willsowerbutts/ersatz80/hardware-schematic-rev2.pdf

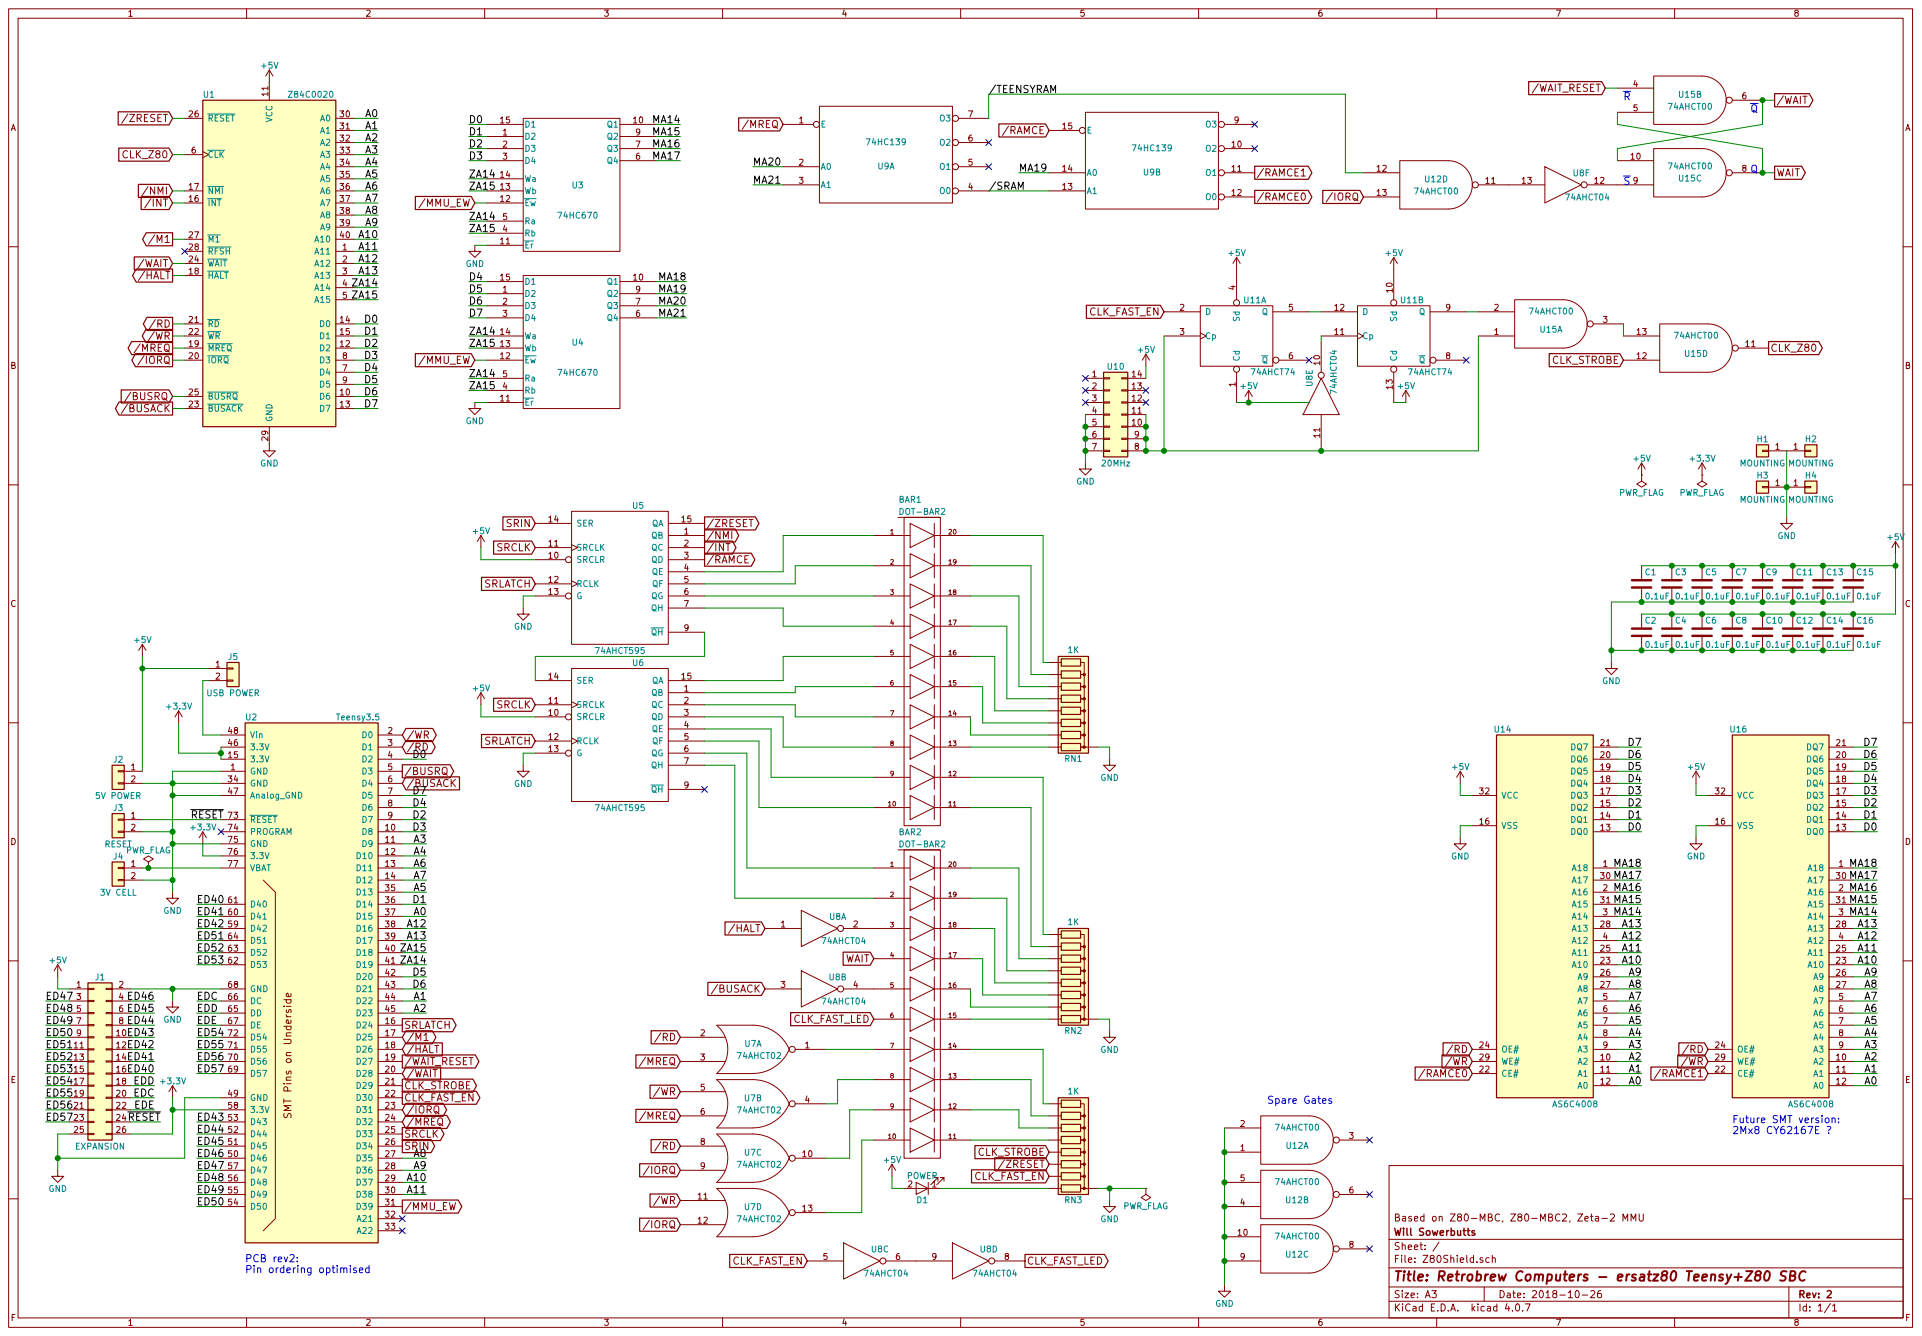
[picture p2: page 1]

5 | 10

15 | 16
17 | 18 | EDD
19 | 20 | EDC
21 | 22 | EDE

File: Z80Shield.sch Sheet: / Will Sowerbutts Based on Z80-MBC, Z80-MBC2, Zeta-2 MMU

Id: 1/1 Title: Retrobrew Computers - ersatz80 Teensy+Z80 SBC
