willsowerbutts/ersatz80/super.cpp

#include <string.h>
#include <stdlib.h>
#include <stdio.h>
#include "z80.h"
#include "z80io.h"
#include "clock.h"
#include "serial.h"
#include "super.h"
#include "debug.h"
#include "rom.h"
#include "disk.h"

#define SBUFLEN 80
#define SMAXARG 10
int supervisor_cmd_offset = 0;
char supervisor_cmd_buffer[SBUFLEN];

typedef struct {
    const char *name;
    void (*function)(int argc, char *argv[]);
} cmd_entry_t;

void super_reset(int argc, char *argv[]);
void super_regs(int argc, char *argv[]);
void super_clk(int argc, char *argv[]);
void super_step(int argc, char *argv[]);
void super_loadrom(int argc, char *argv[]);
void super_loadfile(int argc, char *argv[]);
void super_trace(int argc, char *argv[]);
void super_ls(int argc, char *argv[]);
void super_rm(int argc, char *argv[]);
void super_cp(int argc, char *argv[]);
void super_mv(int argc, char *argv[]);
void super_disk(int argc, char *argv[]);
void super_sync(int argc, char *argv[]);
void super_format(int argc, char *argv[]);
void super_help(int argc, char *argv[]);
void super_in(int argc, char *argv[]);
void super_out(int argc, char *argv[]);
void super_run(int argc, char *argv[]);
void super_exec(int argc, char *argv[]);
void super_mode(int argc, char *argv[]);
void super_mount(int argc, char *argv[]);
void super_umount(int argc, char *argv[]);
void super_uart0(int argc, char *argv[]);

const cmd_entry_t cmd_table[] = {
    { "help",       &super_help     }, // despite the name, not actually super helpful
    { "quit",       NULL            },
    { "exit",       NULL            },
    { "q",          NULL            },
    { "uart0",      &super_uart0    },
    { "regs",       &super_regs     },
    { "clk",        &super_clk      },
    { "clock",      &super_clk      },
    { "step",       &super_step     },
    { "s",          &super_step     },
    { "reset",      &super_reset    },
    { "loadrom",    &super_loadrom  },
    { "loadfile",   &super_loadfile },
    { "trace",      &super_trace    },
    { "ls",         &super_ls       },
    { "dir",        &super_ls       },
    { "mv",         &super_mv       },
    { "ren",        &super_mv       },
    { "rename",     &super_mv       },
    { "rm",         &super_rm       },
    { "del",        &super_rm       },
    { "cp",         &super_cp       },
    { "copy",       &super_cp       },
    { "disk",       &super_disk     },
    { "disks",      &super_disk     },
    { "mount",      &super_mount    },
    { "unmount",    &super_umount   },
    { "umount",     &super_umount   },
    { "format",     &super_format   },
    { "sync",       &super_sync     },
    { "in",         &super_in       },
    { "out",        &super_out      },
    { "run",        &super_run      },
    { "exec",       &super_exec     },
    { "mode",       &super_mode     },

    // list terminator:
    { NULL,         NULL            }
};

static bool not_in_supervised_mode(void)
{
    if(clk_is_supervised())
        return false;
    report("ersatz80: this command can only be used in supervisor mode\r\n");
    return true;
}

bool parse_int16(const char *arg, uint16_t *value, int base)
{
    char *endptr = NULL;
    uint16_t val;

    *value = 0;
    val = strtol(arg, &endptr, base);
    if(val == 0 && endptr == NULL)
        return false;
    if(*endptr != 0 && !isspace(*endptr))
        return false;

    *value = val;
    return true;
}

bool supervisor_menu_key_in(unsigned char keypress)
{
    if(keypress == 0x7f || keypress == 0x08){ // backspace and delete
        if(supervisor_cmd_offset > 0){
            Serial.write("\x08 \x08"); // erase last char
            supervisor_cmd_offset--;
        }
    }else if(keypress == 0x0d || keypress == 0x0a){
        supervisor_cmd_buffer[supervisor_cmd_offset] = 0;
        report("\r\n");
        execute_supervisor_command(supervisor_cmd_buffer);
        return false;
    }else if(keypress == 0x1B /* Esc */ || keypress == SUPERVISOR_ESCAPE_KEYCODE){
        report("*abort*\r\n");
        return false;
    }else if(keypress >= 0x20){
        if(supervisor_cmd_offset < (SBUFLEN-1)){
            supervisor_cmd_buffer[supervisor_cmd_offset++] = keypress;
            report("%c", keypress);
        }else{
            Serial.write(0x07); // sound the bell
        }
    }
    return true;
}

void supervisor_menu_enter(void)
{
    supervisor_cmd_offset = 0;
    report("Supervisor> ");
}

bool execute_supervisor_command(char *cmd_buffer) // return false on exit/quit etc, true otherwise
{
    int argc = 0;
    char *p, *argv[SMAXARG];

    p = cmd_buffer;
    while(*p){
        while(isspace(*p)) // skip over leading whitespace
            p++;
        if(!*p) // end of line?
            break;
        argv[argc++] = p; // store ptr to start of command
        while(*p && !isspace(*p)) // find end of command
            p++;
        if(!*p) // end of line?
            break;
        *(p++) = 0; // overwrite whitespace with NUL
    }

    if(argc == 0)
        return true;

    for(const cmd_entry_t *cmd=cmd_table; cmd->name; cmd++){
        if(!strcasecmp(argv[0], cmd->name)){
            if(cmd->function == NULL){
                return false;
            }else{
                cmd->function(argc-1, argv+1);
                return true;
            }
        }
    }

    report("error: unknown command \"%s\"\r\n", argv[0]);

    return true;
}

void super_regs(int argc, char *argv[])
{
    // parsing isn't quite right
    // it'd be nice to be able to run: regs hl=1111 bc=2222 de=3333 af=0000 (etc)
    if(argc == 1 && !strcasecmp(argv[0], "show"))
        z80_show_regs();
    else if(argc == 2){
        uint16_t value;
        if(!parse_int16(argv[1], &value, 16)){
            report("error: bad register value\r\n");
            return;
        }
        if(     !strcasecmp(argv[0], "AF"))  z80_set_register(Z80_REG_AF,     value);
        else if(!strcasecmp(argv[0], "BC"))  z80_set_register(Z80_REG_BC,     value);
        else if(!strcasecmp(argv[0], "DE"))  z80_set_register(Z80_REG_DE,     value);
        else if(!strcasecmp(argv[0], "HL"))  z80_set_register(Z80_REG_HL,     value);
        else if(!strcasecmp(argv[0], "IX"))  z80_set_register(Z80_REG_IX,     value);
        else if(!strcasecmp(argv[0], "IY"))  z80_set_register(Z80_REG_IY,     value);
        else if(!strcasecmp(argv[0], "AF'")) z80_set_register(Z80_REG_AF_ALT, value);
        else if(!strcasecmp(argv[0], "BC'")) z80_set_register(Z80_REG_BC_ALT, value);
        else if(!strcasecmp(argv[0], "DE'")) z80_set_register(Z80_REG_DE_ALT, value);
        else if(!strcasecmp(argv[0], "HL'")) z80_set_register(Z80_REG_HL_ALT, value);
        else if(!strcasecmp(argv[0], "PC"))  z80_set_register(Z80_REG_PC,     value);
        else if(!strcasecmp(argv[0], "SP"))  z80_set_register(Z80_REG_SP,     value);
        else if(!strcasecmp(argv[0], "I"))   z80_set_register(Z80_REG_I,      value);
        else report("Unrecognised register\r\n");
    }else{
        report("syntax: regs [show|af|bc|de|hl|ix|iy|af'|bc'|de'|hl'|pc|sp|i] <value>\r\n");
    }
}

void super_step(int argc, char *argv[])
{
    if(not_in_supervised_mode())
        return;

    while(instruction_clock_cycles == 0){
        z80_clock_pulse();
        handle_z80_bus();
    }

    while(instruction_clock_cycles != 0){
        z80_clock_pulse();
        handle_z80_bus();
    }
}

void super_clk(int argc, char *argv[])
{
    float f;
    bool setclk = true;

    if(argc == 0){
        setclk = false; // we just want the report that follows
    }else if(argc == 1 && !strcasecmp(argv[0], "fast")){
        f = CLK_FAST_FREQUENCY;
    }else if(argc == 1){
        char *endptr = NULL;
        f = strtof(argv[0], &endptr);
        if(f == 0 && endptr == argv[0]){
            report("error: bad frequency\r\n");
            return;
        }else{
            switch(*endptr){
                case 0:
                    break;
                case 'k':
                case 'K':
                    f *= 1000;
                    break;
                case 'm':
                case 'M':
                    f *= 1000000;
                    break;
                case 'g': // possibly getting a bit ambitious here!
                case 'G':
                    f *= 1000000000;
                    break;
                default:
                    report("error: unrecognised unit suffix?\r\n");
                    return;
            }
        }
    }else{
        report("error: syntax: clk [fast|<freq[kHz|MHz|GHz]>]\r\n");
        return;
    }

    if(setclk){
        if(clk_is_supervised())
            clk_set_supervised_frequency(f);
        else
            clk_set_unsupervised_frequency(f);
    }

    report("clock: %s ", clk_is_supervised() ? "supervised" : "unsupervised");
    f = clk_is_supervised() ? clk_get_supervised_frequency() : clk_get_unsupervised_frequency();
    if(f >= 950000.0)
        report("%.3fMHz", f / 1000000.0);
    else if(f > 950.0)
        report("%.3fkHz", f / 1000.0);
    else
        report("%.3fHz", f);
    report("\r\n");
}

void super_loadrom(int argc, char *argv[])
{
    load_program_to_sram(monitor_rom, MONITOR_ROM_START, MONITOR_ROM_SIZE, MONITOR_ROM_START);
    report("loadrom: monitor loaded at %04x\r\n", MONITOR_ROM_START);
}

void super_reset(int argc, char *argv[])
{
    z80_do_reset();
}

// loadfile could be improved: take a file start offset and a byte count to load?
void super_loadfile(int argc, char *argv[])
{
    int r;
    if(argc < 2){
        report("error: syntax: loadfile [filename] [address]\r\n"
                "note: address is in hex\r\n");
    }else {
        uint16_t address;
        if(!parse_int16(argv[1], &address, 16)){
            report("error: bad load address\r\n");
        }else{
            report("loadfile \"%s\" at 0x%04x: ", argv[0], address);
            r = load_file_to_sram(argv[0], address);
            if(r < 0)
                report("failed\r\n");
            else
                report("loaded %d bytes\r\n", r);
        }
    }
}

void super_trace(int argc, char *argv[])
{
    bool help = false;

    if(not_in_supervised_mode())
        return;

    if(argc != 1)
        help = true;
    else{
        if(!strcasecmp(argv[0], "silent") || !strcasecmp(argv[0], "off"))
            z80_bus_trace = TR_SILENT;
        else if(!strcasecmp(argv[0], "inst"))
            z80_bus_trace = TR_INST;
        else if(!strcasecmp(argv[0], "bus"))
            z80_bus_trace = TR_BUS;
        else
            help = true;
    }

    if(help){
        report("error: trace [off|silent|inst|bus]\r\n");
    }
}

void super_disk(int argc, char *argv[])
{
    for(int d=0; d<NUM_DISK_DRIVES; d++){
        report("Disk %d: filename \"%s\", ", d, disk[d].filename);
        if(disk[d].mounted){
            report("mounted, %.3fMB, %d x %d byte sectors, %s\r\n",
                    (float)disk[d].size_bytes / (1024.0 * 1024.0),
                    disk[d].size_bytes >> disk[d].sector_size_log,
                    1 << disk[d].sector_size_log,
                    disk[d].writable ? "read-write" : "read-only");
        }else{
            report("unmounted\r\n");
        }
    }
}

void super_ls(int argc, char *argv[])
{
    sdcard.ls(LS_DATE | LS_SIZE | LS_R);
    // TODO: improve this!
}

void super_sync(int argc, char *argv[])
{
    disk_sync();
}

void super_format(int argc, char *argv[])
{
    if(argc != 2){
        report("error: syntax: format [filename] [size]\r\n"
               "note: size is in bytes; add K suffix for KB, M suffix for MB, G suffix for GB.\r\n");
    }else{
        float size = 0;
        char *endptr = NULL;
        uint32_t sb;
        size = strtof(argv[1], &endptr);
        if(size == 0 && endptr == argv[0]){
            report("error: bad size\r\n");
            return;
        }else{
            switch(*endptr){
                case 0:
                    break;
                case 'g':
                case 'G':
                    size *= 1024;
                    // fall through
                case 'm':
                case 'M':
                    size *= 1024;
                    // fall through
                case 'k':
                case 'K':
                    size *= 1024;
                    break;
                default:
                    report("error: unrecognised unit suffix?\r\n");
                    return;
            }
        }
        if(size > (2.0f * 1024.0 * 1024.0 * 1024.0)){
            report("error: maximum supported disk size is 2GB\r\n");
            return;
        }
        sb = (uint32_t)size;
        if(sb & 0x3FF)
            report("disk: WARNING: size is not a multiple of 1024 (good luck)\r\n");
        if(disk_format(argv[0], sb))
            report("disk: successfully formatted \"%s\" (%d bytes)\r\n", argv[0], sb);
        else
            report("disk: failed to format \"%s\" (%d bytes)\r\n", argv[0], sb);
    }
}

void super_rm(int argc, char *argv[])
{
    if(argc != 1){
        report("error: syntax: rm [filename]\r\n");
    }else{
        if(!disk_rm(argv[0]))
            report("error: rm failed\r\n");
    }
}

void super_cp(int argc, char *argv[])
{
    if(argc != 2){
        report("error: syntax: cp [source] [target]\r\n");
    }else{
        if(!disk_cp(argv[0], argv[1]))
            report("error: cp failed\r\n");
    }
}

void super_mv(int argc, char *argv[])
{
    if(argc != 2){
        report("error: syntax: mv [source] [target]\r\n");
    }else{
        if(!disk_mv(argv[0], argv[1]))
            report("error: cp failed\r\n");
    }
}

void super_uart0(int argc, char *argv[])
{
    int baud;
    char *endptr = NULL;

    if(argc == 1){
        if(strcasecmp(argv[0], "usb") == 0){
            uart0_on_console = true;
            report("uart0: using usb ACM device\r\n");
            return;
        }

        if(strcasecmp(argv[0], "uart") == 0){
            baud = 115200;
        }else{
            baud = strtol(argv[0], &endptr, 10);
            if(baud == 0 || !endptr || *endptr != 0)
                baud = 0;
        }

        if(baud){
            uart_setup(baud);
            report("uart0: using UART6 at %d baud\r\n", baud);
            if(uart0_on_console)
                supervisor_menu_enter();
            uart0_on_console = false;
            return;
        }

        report("error: syntax: uart0 [usb|uart|<baud>]\r\n");
    }

}

void super_help(int argc, char *argv[])
{
    void (*prev_func)(int argc, char *argv[]) = NULL;

    report("commands:");
    for(const cmd_entry_t *cmd=cmd_table; cmd->name; cmd++){
        if(cmd->function != prev_func)
            report(" %s", cmd->name);
        prev_func = cmd->function;
    }
    report("\r\n");
}

void super_in(int argc, char *argv[])
{
    if(argc != 1){
        report("error: syntax: in [port]\r\n");
    }else {
        uint16_t port, value;
        if(!parse_int16(argv[0], &port, 16)){
            report("error: bad port address\r\n");
        }else{
            // TODO check this is safe (previously we would explicitly switch to DMA mode)
            value = iodevice_read(port);
            report("input from I/O port 0x%04x: 0x%02x\r\n", port, value);
        }
    }
}

void super_out(int argc, char *argv[])
{
    if(argc != 2){
        report("error: syntax: out [port] [value]\r\n");
    }else {
        uint16_t port, value;
        if(!parse_int16(argv[0], &port, 16)){
            report("error: bad port address\r\n");
        }else{
            if(!parse_int16(argv[1], &value, 16) || value > 0xFF)
                report("error: bad value\r\n");
            else{
                // TODO check this is safe (previously we would explicitly switch to DMA mode)
                iodevice_write(port, value);
            }
        }
    }
}

void super_run(int argc, char *argv[])
{
    if(argc != 1){
        report("error: syntax: run [address]\r\n");
    }else {
        uint16_t address;
        if(!parse_int16(argv[0], &address, 16)){
            report("error: bad address\r\n");
        }else{
            z80_mode_t prev_mode = z80_set_mode(Z80_SUPERVISED);
            z80_set_register(Z80_REG_PC, address);
            z80_set_mode(prev_mode);
        }
    }
}

void super_exec(int argc, char *argv[])
{
    if(argc != 1){
        report("error: syntax: exec [filename]\r\n");
        return;
    }

    SdBaseFile file;

    if(!file.open(&sdcard, argv[0], O_RDONLY)){
        report("exec: Cannot open \"%s\"\r\n", argv[0]);
        return;
    }
    // note that we shortly will overwrite the strings that argv[] point to, so can't use argv[0] again
    
    while(file.fgets(supervisor_cmd_buffer, SBUFLEN) > 0){
        int l = strlen(supervisor_cmd_buffer);
        while(l > 0 && isspace(supervisor_cmd_buffer[l-1])){
            supervisor_cmd_buffer[--l] = 0;
        }
        report("exec: \"%s\"\r\n", supervisor_cmd_buffer);
        execute_supervisor_command(supervisor_cmd_buffer);
    }

    file.close();
}

void super_mount(int argc, char *argv[])
{
    uint16_t disknum;
    bool readwrite = true;
    if(argc < 1 || argc > 3){
        report("error: syntax: mount [disknum] <filename> <ro|rw>\r\n");
        return;
    }
    if(!parse_int16(argv[0], &disknum, 10) || disknum >= NUM_DISK_DRIVES){
        report("error: bad disk number (0--%d)\r\n", NUM_DISK_DRIVES-1);
        return;
    }
    disk_unmount(disknum);
    if(argc >= 3){
        if(strcasecmp(argv[2], "ro") == 0)
            readwrite = false;
        else if(strcasecmp(argv[2], "rw") == 0)
            readwrite = true;
        else{
            report("error: bad read-only/read-write flag\r\n");
            return;
        }
    }
    if(argc >= 2){
        strncpy(disk[disknum].filename, argv[1], MAX_FILENAME_LENGTH);
        disk[disknum].filename[MAX_FILENAME_LENGTH-1] = 0; // ensure string is terminated
    }
    disk_mount(disknum, readwrite);
}

void super_umount(int argc, char *argv[])
{
    uint16_t disknum;
    if(argc != 1){
        report("error: syntax: unmount [disknum]\r\n");
        return;
    }
    if(!parse_int16(argv[0], &disknum, 10) || disknum >= NUM_DISK_DRIVES){
        report("error: bad disk number (0--%d)\r\n", NUM_DISK_DRIVES-1);
        return;
    }
    disk_unmount(disknum);
}

void super_mode(int argc, char *argv[])
{
    bool bad = false;
    
    if(argc > 1)
        bad = true;

    if(argc == 1){
        if(strcasecmp(argv[0], "supervised") == 0 || strcasecmp(argv[0], "s") == 0)
            z80_set_mode(Z80_SUPERVISED);
        else if(strcasecmp(argv[0], "unsupervised") == 0 || strcasecmp(argv[0], "u") == 0)
            z80_set_mode(Z80_UNSUPERVISED);
        else
            bad=true;
    }

    if(bad){
        report("error: syntax: mode [supervised|unsupervised|s|u]\r\n");
        return;
    }

    report("mode: %ssupervised\r\n", clk_is_supervised() ? "":"un");
}
