willsowerbutts/ersatz80/disasm.cpp

/* this is a modified version of disasm.c taken from:
 * z80ctrl (https://github.com/jblang/z80ctrl)
 * Copyright 2018 J.B. Langston
 *
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
 * THE SOFTWARE IS PROVIDED "AS IS", WITHOUT WARRANTY OF ANY KIND, EXPRESS OR
 * IMPLIED, INCLUDING BUT NOT LIMITED TO THE WARRANTIES OF MERCHANTABILITY,
 * FITNESS FOR A PARTICULAR PURPOSE AND NONINFRINGEMENT. IN NO EVENT SHALL THE
 * AUTHORS OR COPYRIGHT HOLDERS BE LIABLE FOR ANY CLAIM, DAMAGES OR OTHER
 * LIABILITY, WHETHER IN AN ACTION OF CONTRACT, TORT OR OTHERWISE, ARISING
 * FROM, OUT OF OR IN CONNECTION WITH THE SOFTWARE OR THE USE OR OTHER
 * DEALINGS IN THE SOFTWARE.
 */

#include <stdint.h>
#include <string.h>
#include <stdio.h>

/**
 * @file disasm.c Z80 disassembler
 *
 * This disassembler decodes Z80 instructions using techniques described
 * in http://www.z80.info/decoding.htm.
 */

/**
 *  8-bit registers
 */
const char *registers[] = {"B", "C", "D", "E", "H", "L", "(HL)", "A", "IXH", "IXL", "IYH", "IYL"};
enum {B, C, D, E, H, L, HLI, A, IXH, IXL, IYH, IYL};

/**
 *  16-bit register pairs
 */
const char *register_pairs[] = {"BC", "DE", "HL", "SP", "AF", "IX", "IY"};
enum {BC, DE, HL, _SP, AF, IX, IY};

/**
 * condition codes
 */
const char *conditions[] = {"NZ", "Z", "NC", "C", "PO", "PE", "P", "M"};

/**
 * arithmetic/logic operations
 */
const char *alu_ops[] = {"ADD A,", "ADC A,", "SUB ", "SBC A,", "AND ", "XOR ", "OR ", "CP "};

/**
 * rotation/shift operations
 */
const char *rot_ops[] = {"RLC", "RRC", "RL", "RR", "SLA", "SRA", "SLL", "SRL"};

/**
 * interrupt modes
 */
const char *int_modes[] = {"0", "0", "1", "2"};

/**
 * block instructions
 */
const char *block_ops[] = {
    "LDI", "LDD", "LDIR", "LDDR",
    "CPI", "CPD", "CPIR", "CPDR",
    "INI", "IND", "INIR", "INDR",
    "OUTI", "OUTD", "OTIR", "OTDR"
};

/**
 * indirect load ops
 */
const char *ld_ops[] = {"LD (BC),A", "LD A,(BC)", "LD (DE),A", "LD A,(DE)"};

/**
 * accumulator and flag ops for x = 0, z = 7
 */
const char *af_ops[] = {"RLCA", "RRCA", "RLA", "RRA", "DAA", "CPL", "SCF", "CCF"};

/**
 * miscellaneous 0xED operations
 */
const char *misc_ops[] = {"LD I,A", "LD R,A", "LD A,I", "LD A,R", "RRD", "RLD", "NOP", "NOP"};

const char *bit_ops[] = {"BIT", "RES", "SET"};

/**
 * disassemble a single instruction
 */
void z80ctrl_disasm(uint8_t (*input)(), char *output)
{
    uint8_t opcode = 0;
    uint8_t prefix = 0;
    uint8_t displ = 0;
    uint16_t operand = 0;
    uint8_t im = HL;

    // Consume any number of 0xDD and 0xFD prefix bytes
    // and set index mode according to last one encountered.
    for (;;) {
            opcode = input();
            if (opcode == 0xDD)
                im = IX;
            else if (opcode == 0xFD)
                im = IY;
            else
                break;
    }

    if (opcode == 0xED) {
            prefix = 0xED;
            im = HL;            // Index mode for 0xED prefix is always HL
            opcode = input();
    } if (opcode == 0xCB) {
        prefix = 0xCB;
        if (im != HL)
                displ = input();
        opcode = input();
    }

    // bit slice the opcode: xxyyyzzz / xxppqzzz
    uint8_t x = (opcode & 0300) >> 6;       // x = opcode[7:6]
    uint8_t y = (opcode & 0070) >> 3;       // y = opcode[5:3]
    uint8_t z = (opcode & 0007);            // z = opcode[2:0]
    uint8_t p = (opcode & 0060) >> 4;       // p = opcode[5:4]
    uint8_t q = (opcode & 0010) >> 3;       // q = opcode[3]
    uint8_t zy = ((z & 3) << 2) | (y & 3);  // zy = {opcode[1:0], opcode[4:3]}

    // choose registers based on index mode and y/z/p opcode fields
    const char *rp, *hli, *ry, *rz;
    rp = register_pairs[p == HL ? im : p];
    ry = registers[y];
    rz = registers[z];
    if (im == IX) {
        hli = register_pairs[IX];
    } else if (im == IY) {
        hli = register_pairs[IY];
    } else {
        hli = register_pairs[HL];
    }

    // Big ugly nested if tree to decode opcode
    if (prefix == 0xCB) {
        if (x == 0) {
            // Roll/shift register or memory location
            if (im == HL) {
                sprintf(output, "%s %s", rot_ops[y], rz);
            } else {
                sprintf(output, "%s (%s+0x%02x)", rot_ops[y], hli, displ);
            }
        } else {
            // Bit operations (test reset, set)
            if (im == HL) {
                sprintf(output, "%s %x,%s", bit_ops[x-1], y, rz);
            } else {
                sprintf(output, "%s %x,(%s+0x%02x)", bit_ops[x-1], y, hli, displ);
            }
        }
    } else if (prefix == 0xED) {
        if (x == 1) {
            if (z == 0) {
                // Input from port
                sprintf(output, (y == 6) ? "IN (C)" : "IN %s,(C)", ry);
            } else if (z == 1) {
                // Output to port
                sprintf(output, (y == 6) ? "OUT (C)" : "OUT (C),%s", ry);
            } else if (z == 2) {
                // 16-bit add/subtract with carry
                sprintf(output, (q == 0) ? "SBC HL,%s" : "ADC HL,%s", rp);
            } else if (z == 3) {
                // Retrieve/store register pair from/to immediate address
                operand = input() | (input() << 8);
                if (q == 0) {
                    sprintf(output, "LD (0x%04x),%s", operand, rp);
                } else {
                    sprintf(output, "LD %s,(0x%04x)", rp, operand);
                }
            } else if (z == 4) {
                // Negate accumulator
                strcpy(output, "NEG");
            } else if (z == 5) {
                // Return from interrupt
                strcpy(output, (y == 1) ? "RETI" : "RETN");
            } else if (z == 6) {
                // Set interrupt mode
                sprintf(output, "IM %s", int_modes[y&0x3]);
            } else if (z == 7) {
                // Assorted ops
                strcpy(output, misc_ops[y]);
            }
        } else if (x == 2 && z <= 3 && y >= 4) {
                strcpy(output, block_ops[zy]);
        } else {
            sprintf(output, "?");
        }
    } else {
        // un-prefixed opcodes
        if (x == 0) {
            if (z == 0) {
                // Relative jumps and assorted ops
                if (y == 0) {
                    strcpy(output, "NOP");
                } else if (y == 1) {
                    strcpy(output, "EX AF,AF'");
                } else {
                    operand = input();
                    if (y == 2) {
                        sprintf(output, "DJNZ %d", (int8_t)operand);
                    } else if (y == 3) {
                        sprintf(output, "JR %d", (int8_t)operand);
                    } else {
                        sprintf(output, "JR %s,%d", conditions[y-4], (int8_t)operand);
                    }
                }
            } else if (z == 1) {
                // 16-bit load immediate/add
                if (q == 0) {
                    operand = input() | (input() << 8);
                    sprintf(output, "LD %s,0x%04x", rp, operand);
                } else {
                    sprintf(output, "ADD %s,%s", hli, rp);
                }
            } else if (z == 2) {
                // Indirect loading
                if (y < 4) {
                    strcpy(output, ld_ops[y]);
                } else {
                    operand = input() | (input() << 8);
                    if (p == 3) {
                        hli = "A";
                    }
                    if (q == 0) {
                        sprintf(output, "LD (0x%04x),%s", operand, hli);
                    } else {
                        sprintf(output, "LD %s,(0x%04x)", hli, operand);
                    }
                }
            } else if (z == 3) {
                // 16-bit increment or decrement
                sprintf(output, (q == 0) ? "INC %s" : "DEC %s", rp);
            } else if (z == 4) {
                // 8-bit increment
                if (y == HLI && im != HL) {
                    displ = input();
                    sprintf(output, "INC (%s+0x%02x)", hli, displ);
                } else {
                    sprintf(output, "INC %s", ry);
                }
            } else if (z == 5) {
                // 8-bit decrement
                if (y == HLI && im != HL) {
                    displ = input();
                    sprintf(output, "DEC (%s+0x%02x)", hli, displ);
                } else {
                    sprintf(output, "DEC %s", ry);
                }
            } else if (z == 6) {
                // 8-bit load immediate
                if (y == HLI && im != HL) {
                    displ = input();
                    operand = input();
                    sprintf(output, "LD (%s+0x%02x),0x%02x", hli, displ, operand);
                } else {
                    operand = input();
                    sprintf(output, "LD %s,0x%02x", ry, operand);
                }
            } else if (z == 7) {
                // Assorted operations on accumulator/flags
                strcpy(output, af_ops[y]);
            }
        } else if (x == 1) {
            if (z == HLI && y == HLI) {
                // Exception: HALT replaces LD (HL),(HL)
                strcpy(output, "HALT");
            } else if ((y == HLI || z == HLI) && im != HL) {
                // 8-bit loading
                displ = input();
                if (y == HLI) {
                    sprintf(output, "LD (%s+0x%02x),%s", hli, displ, rz);
                } else {
                    sprintf(output, "LD %s,(%s+0x%02x)", ry, hli, displ);
                }
            } else {
                sprintf(output, "LD %s,%s", ry, rz);
            }
        } else if (x == 2) {
            // ALU operation on accumulator and register/memory location
            if (z == 6 && im != HL) {
                displ = input();
                sprintf(output, "%s(%s+0x%02x)", alu_ops[y], hli, displ);
            } else {
                sprintf(output, "%s%s", alu_ops[y], rz);
            }
        } else if (x == 3) {
            if (z == 0) {
                // Conditional return
                sprintf(output, "RET %s", conditions[y]);
            } else if (z == 1) {
                // POP & various ops
                if (q == 0) {
                    sprintf(output, "POP %s", p < _SP ? rp : register_pairs[AF]);
                } else if (p == 0) {
                    strcpy(output, "RET");
                } else if (p == 1) {
                    strcpy(output, "EXX");
                } else if (p == 2) {
                    sprintf(output, "JP (%s)", hli);
                } else if (p == 3) {
                    sprintf(output, "LD _SP,%s", hli);
                }
            } else if (z == 2) {
                // Conditional jump
                operand = input() | (input() << 8);
                sprintf(output, "JP %s,0x%04x", conditions[y], operand);
            } else if (z == 3) {
                // Assorted operations
                if (y == 0) {
                    operand = input() | (input() << 8);
                    sprintf(output, "JP 0x%04x", operand);
                } else if (y == 1) {
                    strcpy(output, "?"); // CB prefix
                } else if (y == 2) {
                    operand = input();
                    sprintf(output, "OUT (0x%02x),A", operand);
                } else if (y == 3) {
                    operand = input();
                    sprintf(output, "IN A,(0x%02x)", operand);
                } else if (y == 4) {
                    sprintf(output, "EX (_SP),%s", hli);
                } else if (y == 5) {
                    strcpy(output, "EX DE,HL");
                } else if (y == 6) {
                    strcpy(output, "DI");
                } else if (y == 7) {
                    strcpy(output, "EI");
                }
            } else if (z == 4) {
                // Conditional call
                operand = input() | (input() << 8);
                sprintf(output, "CALL %s,0x%04x", conditions[y], operand);
            } else if (z == 5) {
                // PUSH & various ops
                if (q == 0)
                    sprintf(output, "PUSH %s", p < _SP ? rp : register_pairs[AF]);
                else if (p == 0) {
                    operand = input() | (input() << 8);
                    sprintf(output, "CALL 0x%04x", operand);
                }
            } else if (z == 6) {
                // ALU operation on accumulator and immediate operand
                operand = input();
                sprintf(output, "%s0x%02x", alu_ops[y], operand);
            } else if (z == 7) {
                // Restart
                sprintf(output, "RST 0x%02x", y*8);
            }
        }
    }
}
