willsowerbutts/ersatz80/(commit log)

2018-08-10 Boots Z80 to monitor, with working UART
2018-08-23 README: decoupling capacitor
2018-09-12 Import Teensy (ARM) code
2018-09-13 Ah, here's the problem!
    [ersatz80.ino, z80.h]
2018-09-15 Implement slow (PWM) clock
2018-09-16 Run the Teensy at full 120MHz
2018-09-16 Reverse the ordering of the user LEDs
    [z80.cpp]
2018-09-16 Add random LED toy
2018-09-17 Add hardware schematic (PDF)
2018-09-25 Fix slow clock generation
    [clock.cpp, super.cpp]
2018-09-26 Switch to SdFat library, table-based IO registers
2018-09-29 Tidy up trace output a little
2018-09-29 Bugfix: Reads from our peripherals were not reported correctly in traces
    [z80.cpp]
2018-10-02 Bugfix for stopped clock while tracing
    [super.cpp]
2018-10-03 Bugfix: CLK_SUPERVISED would not restart after clk_pause()
    [clock.cpp]
2018-10-03 trace: switch back to internal timer when done
2018-10-04 Add BOM
2018-10-04 Note about capacitors
2018-10-04 Add power LED
2018-10-04 More BOM updates
2018-10-04 Move user LEDs to different I/O addresses
2018-10-04 z80_memory_write_block(): fix off-by-one bug
    [z80.cpp]
2018-10-05 Cheapo timer for benchmarking
2018-10-07 disk: bugfix - final sector calculation was off-by-1
    [disk.cpp]
2018-10-07 disk: detect and handle more error conditions. do not read/write beyond end of file.
    [disk.cpp, disk.h, super.cpp]
2018-10-08 irq: Very simple interrupt controller (bonus -- it's untested!)
2018-10-09 Fix naming UART1->UART0
2018-10-09 Handle interrupt acknowledgement cycles
2018-10-09 Add timer hardware
2018-10-09 disk: detect and reject 0-byte files. Do not mount files with O_CREAT.
2018-10-09 timer: minor tweaks
2018-10-10 mmu: foreign context for disk DMA operations
2018-10-13 Re-organise project folders, bring Teensy code up a level.
2018-10-27 Add hardware schematic for rev2 (PDF)
2018-10-27 Software support (UNTESTED) for PCB rev2
2018-10-27 Clock code updated for PCB rev2 (UNTESTED)
2018-10-28 Switch to arduino-1.8.7
2018-10-30 Add supervisor commands: mount, umount
2018-10-30 mount command now allows read-only disks
2018-10-31 Make PCB rev2 the default
2018-10-31 Fix for internal clock on PCB rev2
    [clock.cpp]
2018-10-31 Fixes to compile without any warnings
    [disasm.cpp, disk.cpp]
2018-11-07 z80_clk_pause(): Use a DMA cycle to ensure that we don't stop in the middle of a multi-byte instruction fetch
2018-11-18 At reset fill Z80 SRAM with HALT instructions
    [z80.cpp]
2018-11-27 WAIT errors: make it clearer who is complaining
    [z80.cpp]
2018-12-28 Allow Z80 uart0 to be switched between USB ACM or UART Serial6
2018-12-29 Tidy up basic build script, UART instructions.
2019-01-02 Track modes for CPU synchronisation and DMA separately
2021-02-21 Switch to newer Arduino, SdFat
2021-12-24 Change to Arduino-1.8.18
2021-12-24 Fix SD card with Teensyduino 1.56
    [disk.cpp, disk.h]
2021-12-24 End DMA mode after loading data to SRAM
2021-12-25 run, regs: switch to supervised mode automatically
2021-12-25 Warn when Z80 halted (needs a proper fix!)
    [interface.h, z80.cpp]
2021-12-25 README: add note about 5V tolerance
2024-06-02 Switch to building with arduino-cli
